patmakesapps/flora-cad/Blender/blender renders/pic_01.png

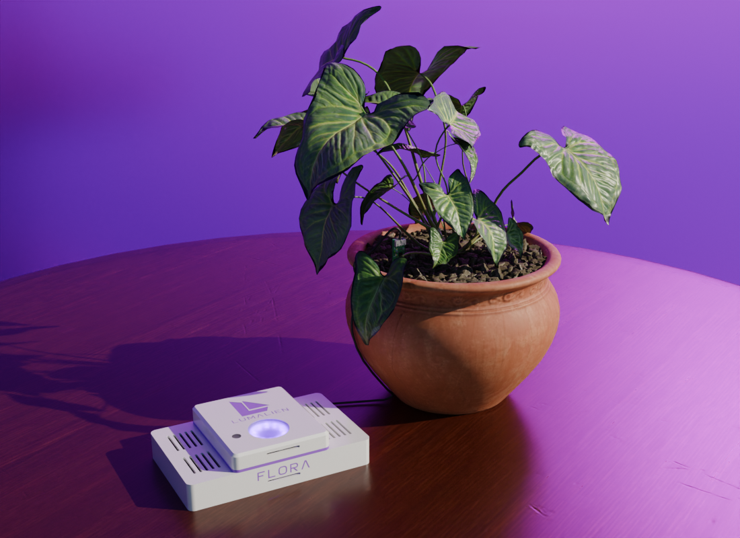
Blender/blender renders/pic_01.png
