patmakesapps/flora-cad/Blender/blender renders/pic_02.png

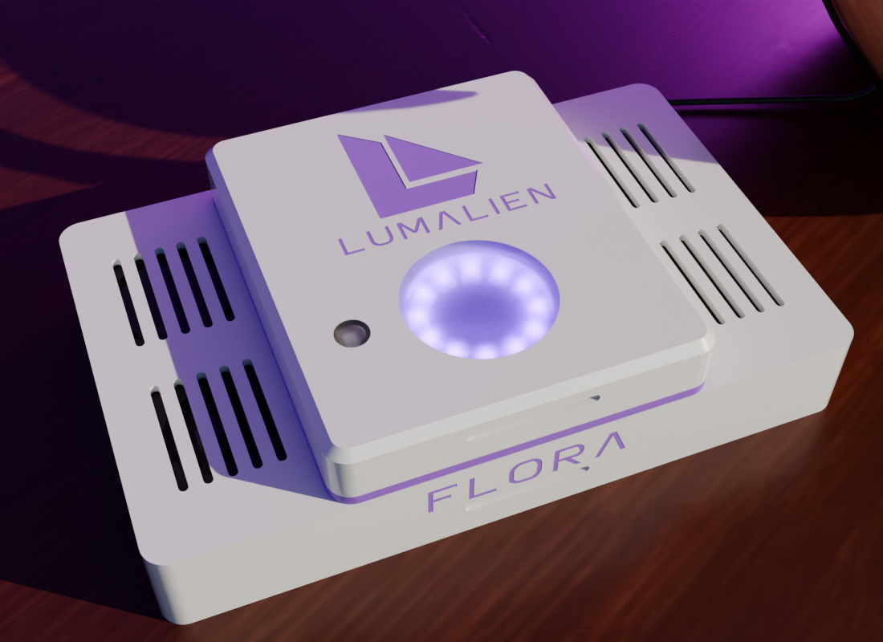
Blender/blender renders/pic_02.png
