patmakesapps/flora-cad/Blender/blender renders/pic_03.png

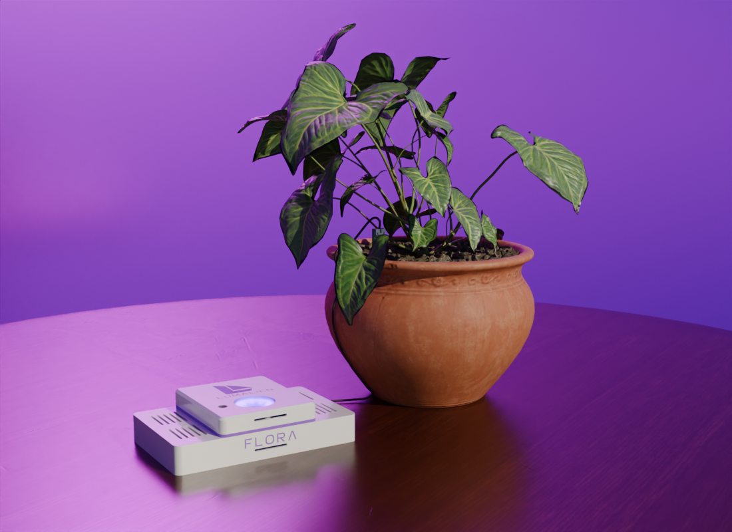
Blender/blender renders/pic_03.png
