patmakesapps/flora-cad/Blender/blender renders/pic_04.png

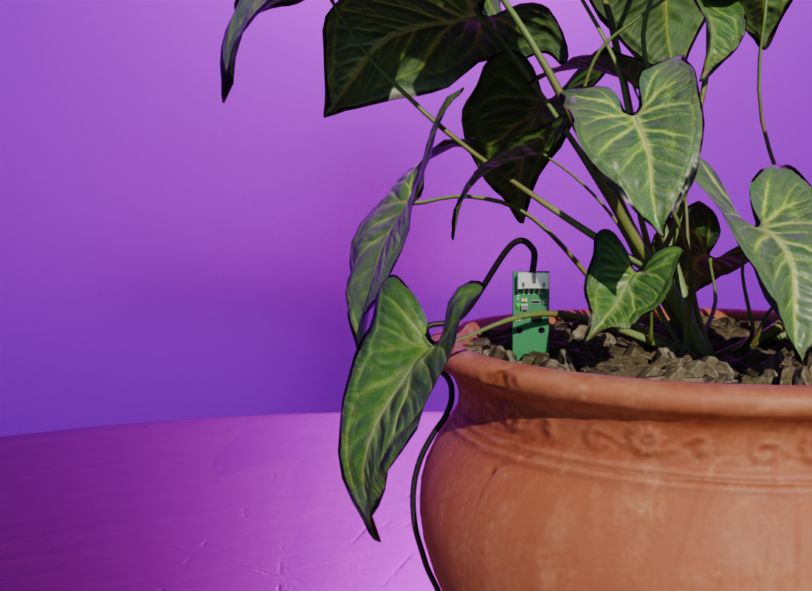
Blender/blender renders/pic_04.png
