patmakesapps/flora-cad/Blender/blender renders/pic_05.png

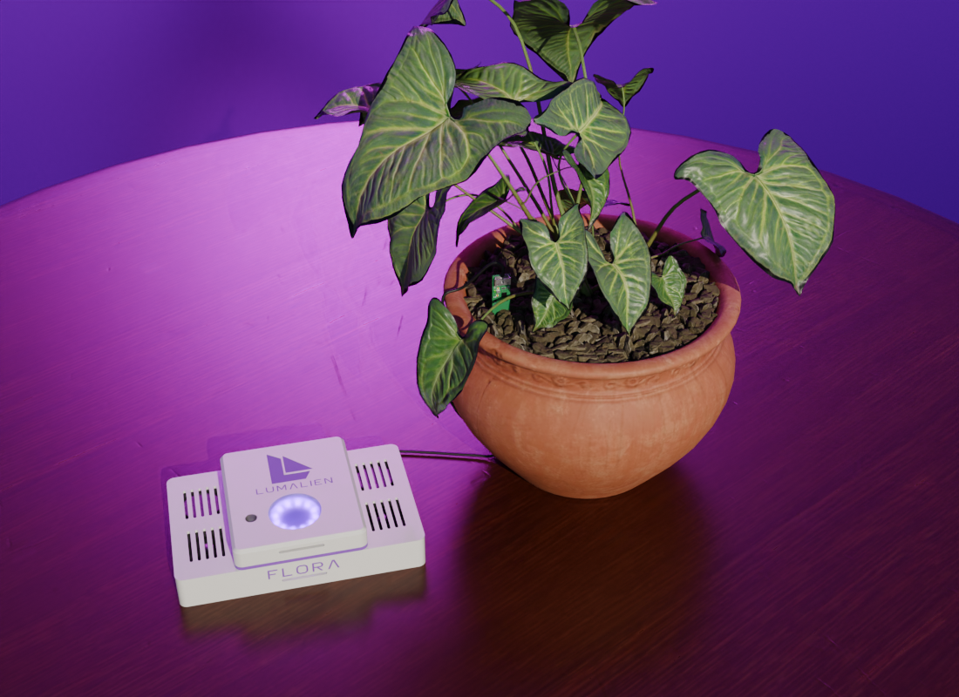
Blender/blender renders/pic_05.png
