patmakesapps/flora-cad/Blender/blender renders/pic_06.png

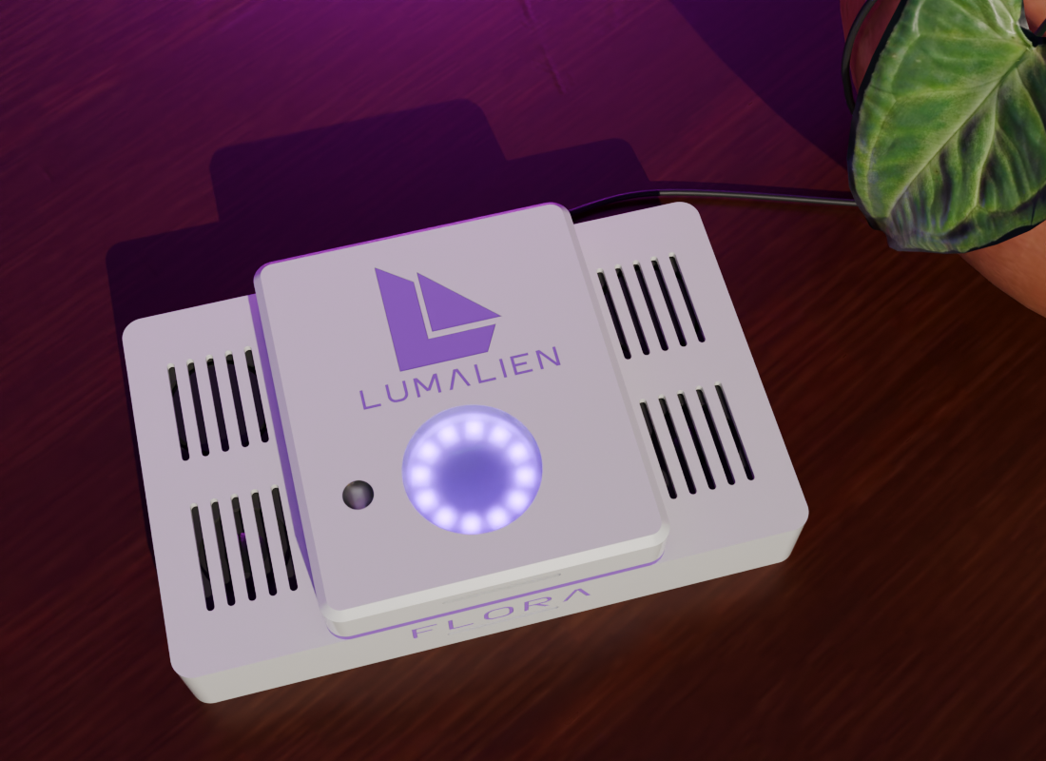
Blender/blender renders/pic_06.png
