patmakesapps/flora-cad/Blender/blender renders/pic_07.png

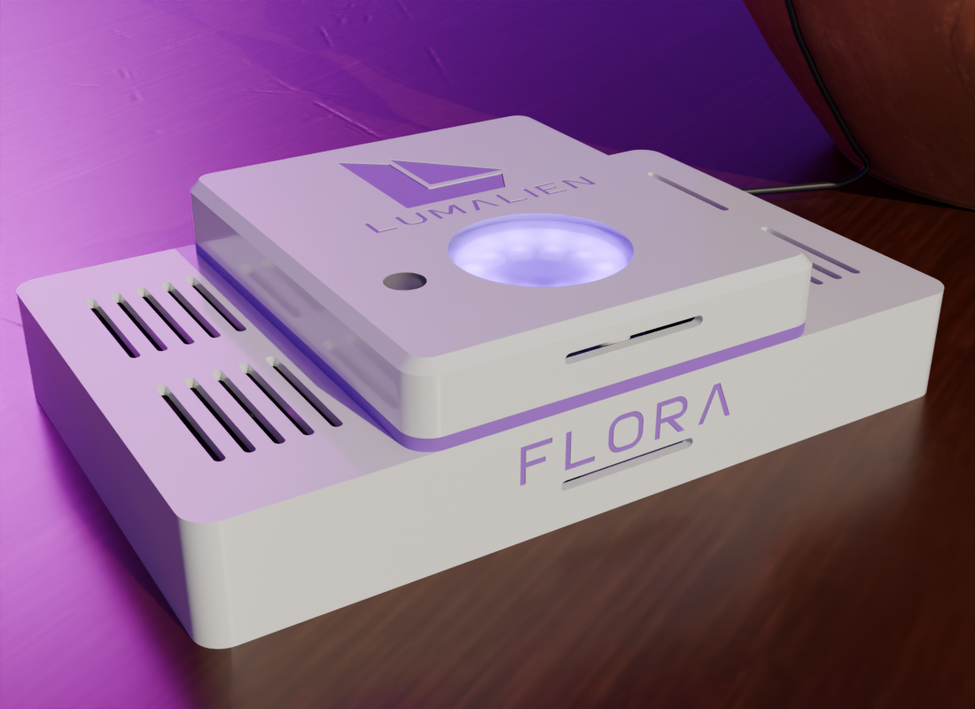
Blender/blender renders/pic_07.png
