patmakesapps/flora-cad/Blender/reference/bench_photos/2026-10-04_bench_01_overview_front_high.jpg

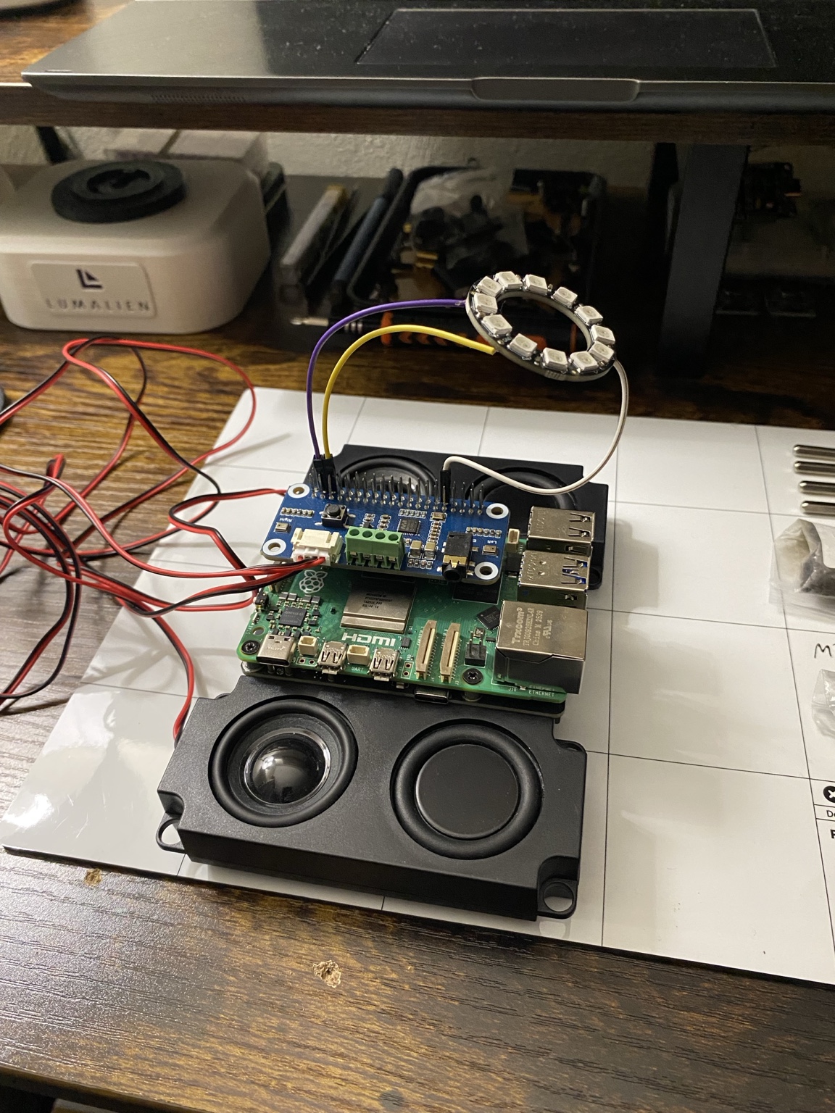
Blender/reference/bench_photos/2026-10-04_bench_01_overview_front_high.jpg
