patmakesapps/flora-cad/Blender/reference/bench_photos/2026-10-04_bench_02_front_usbc_hdmi_edge.jpg

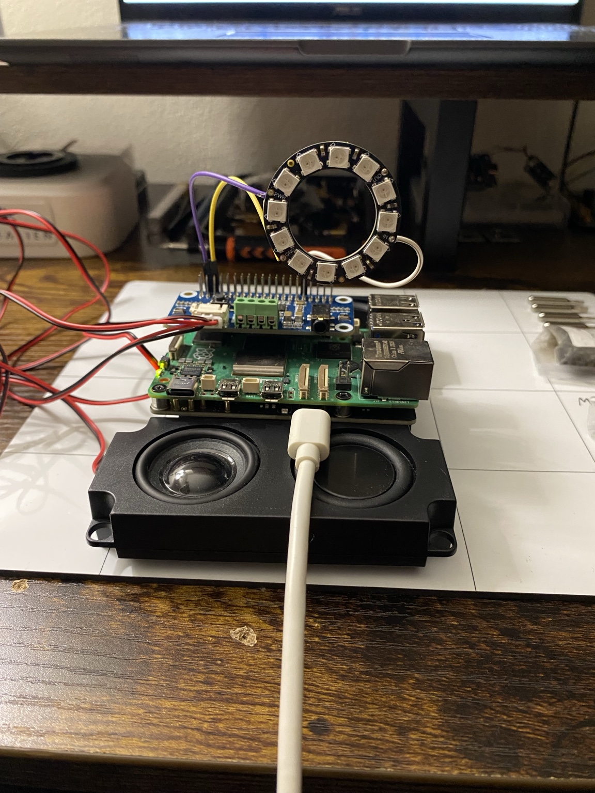
Blender/reference/bench_photos/2026-10-04_bench_02_front_usbc_hdmi_edge.jpg
