patmakesapps/flora-cad/Blender/reference/bench_photos/2026-10-04_bench_03_top_down.jpg

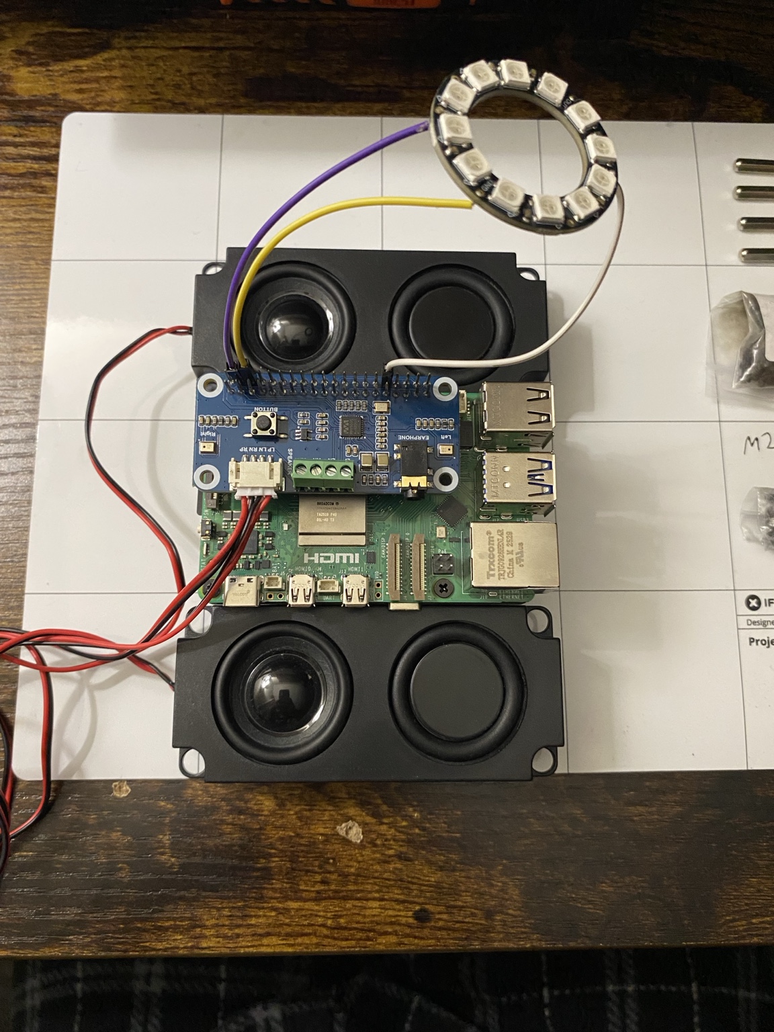
Blender/reference/bench_photos/2026-10-04_bench_03_top_down.jpg
