patmakesapps/flora-cad/Blender/reference/bench_photos/2026-10-04_bench_04_usb_ethernet_end_low.jpg

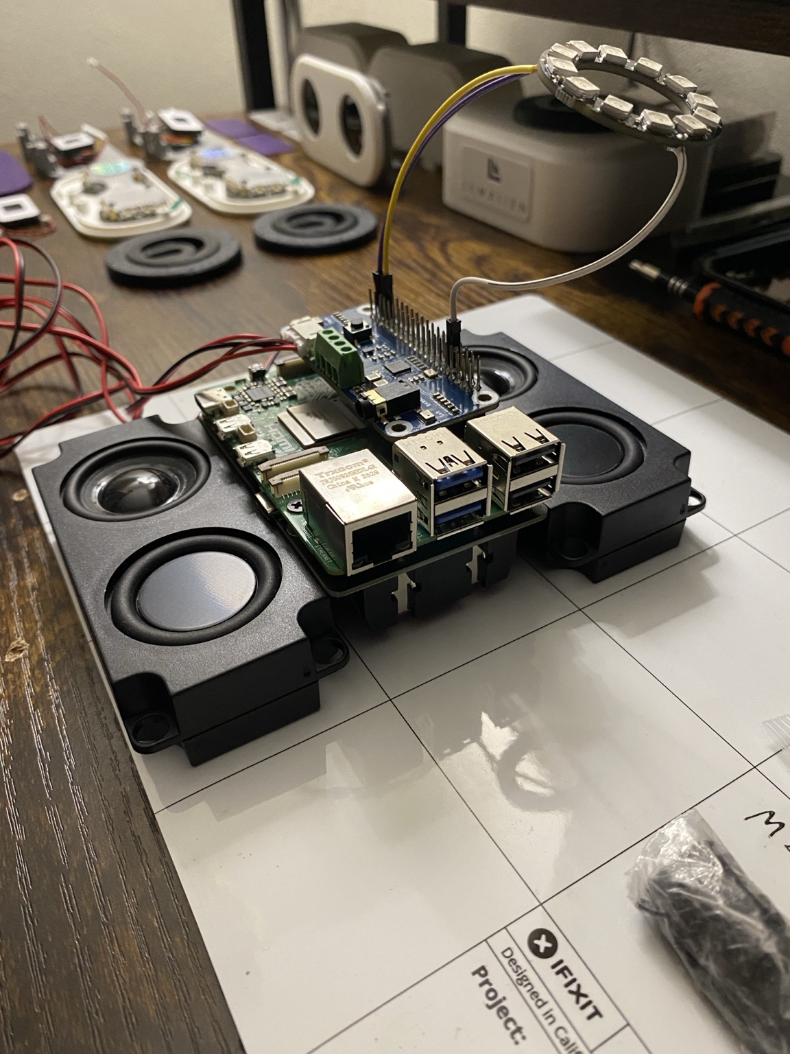
Blender/reference/bench_photos/2026-10-04_bench_04_usb_ethernet_end_low.jpg
