patmakesapps/flora-cad/Blender/reference/bench_photos/2026-10-04_bench_06_pi_stack_only_no_speakers.jpg

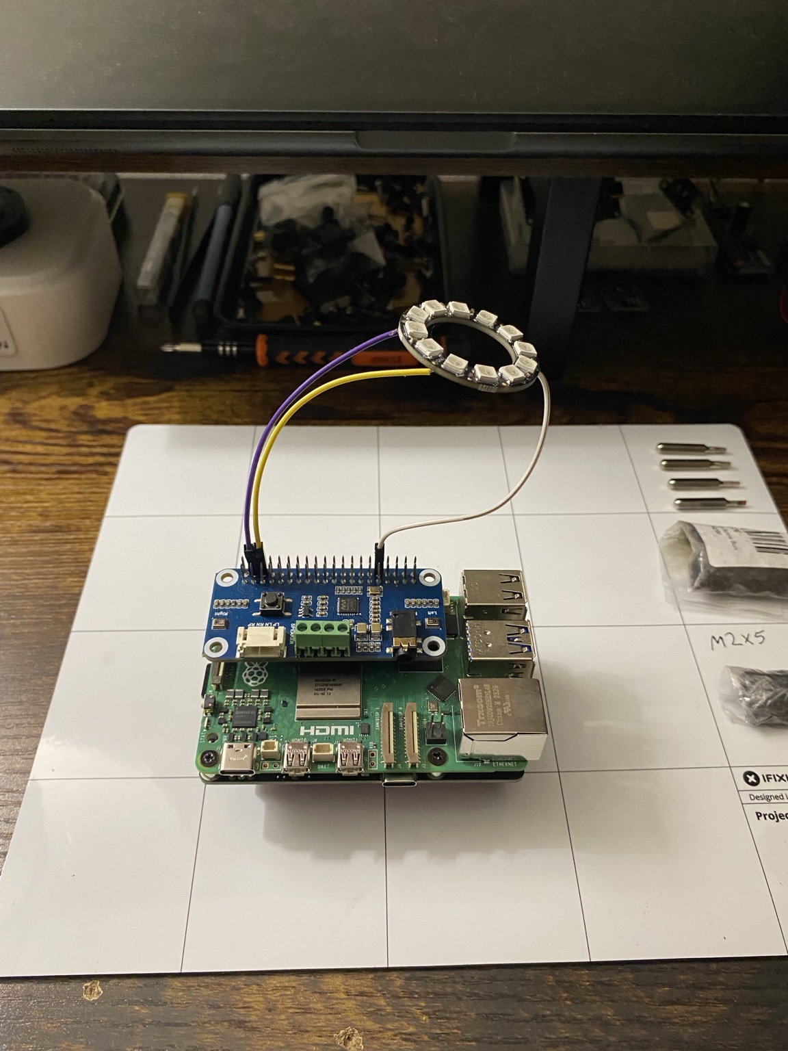
Blender/reference/bench_photos/2026-10-04_bench_06_pi_stack_only_no_speakers.jpg
