patmakesapps/flora-cad/Blender/reference/bench_photos/2026-10-04_bench_07_front_ring_lit_purple.jpg

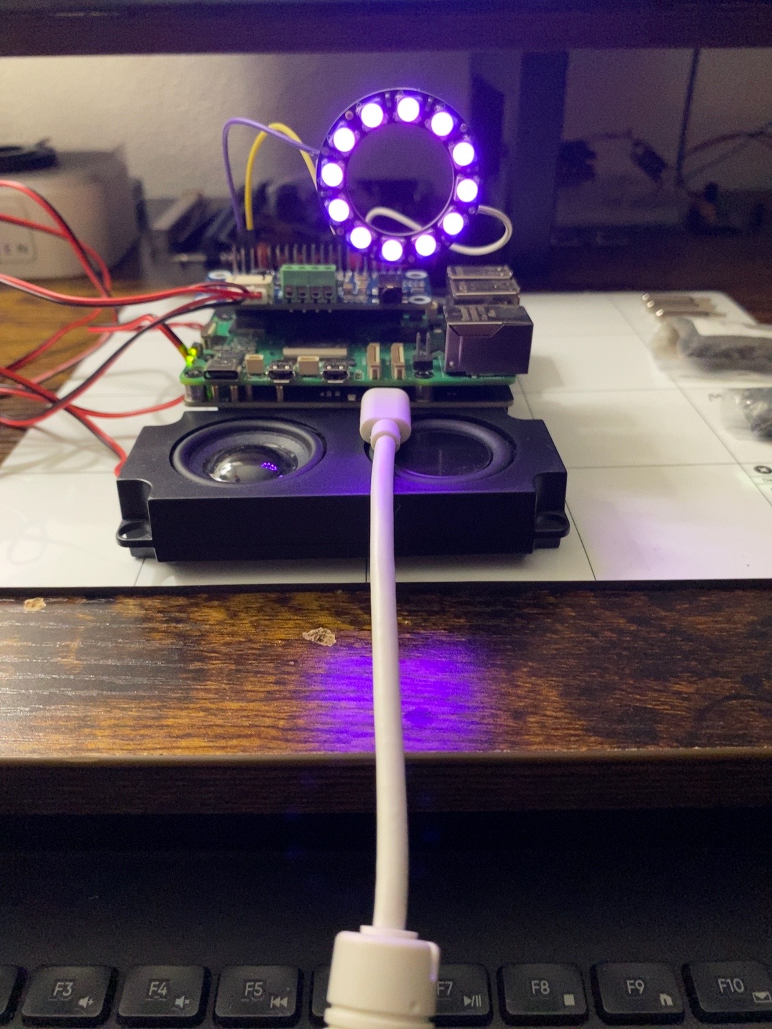
Blender/reference/bench_photos/2026-10-04_bench_07_front_ring_lit_purple.jpg
