patmakesapps/flora-cad/Blender/reference/vendor_cad/adafruit_4026/4026 STEMMA Soil Sensor.step

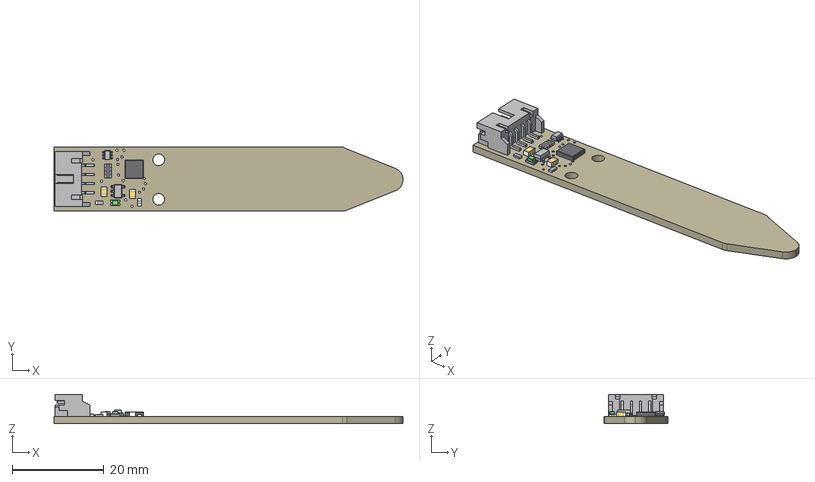
[picture p16: CAD file, 2026-10-05]
Blender/reference/vendor_cad/adafruit_4026/4026 STEMMA Soil Sensor.step
76.2 x 14.0 x 6.37 mm
Board
1K x 2
RED
10uF x 2
MIC5225-3.3
10K
2N7002D
STEMMA_I2C_RASMT
ATSAMD10D14A
