patmakesapps/flora-cad/Blender/reference/vendor_cad/adafruit_4885/4485 SHT40.step

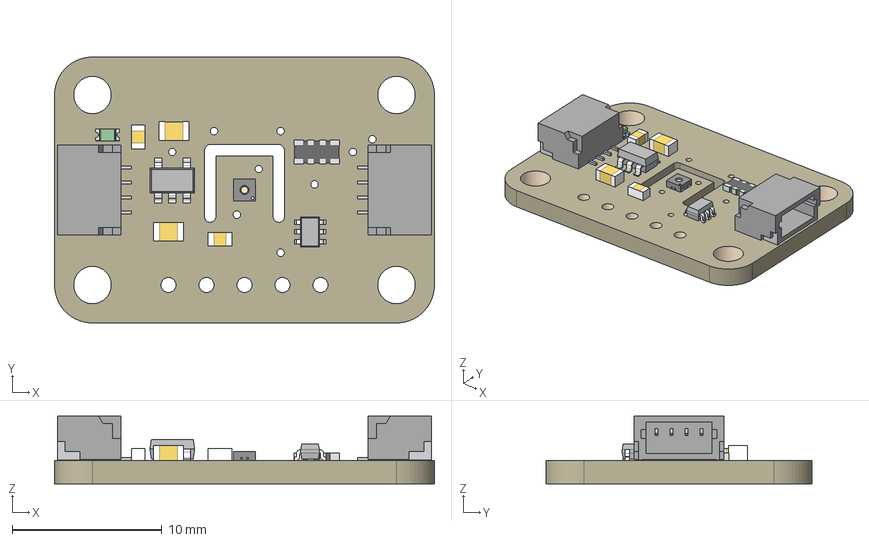
[picture p17: CAD file, 2026-10-05]
Blender/reference/vendor_cad/adafruit_4885/4485 SHT40.step
25.4 x 17.8 x 4.53 mm
Board
10uF x 2
AP2112K-3.3
10K x 2
10K_1
BSS138
STEMMA_I2C_QT x 2
GREEN
SHT4X_
