patmakesapps/flora-cad/Blender/reference/vendor_cad/adafruit_5625/5625 Stemma 5 Port Hub.step

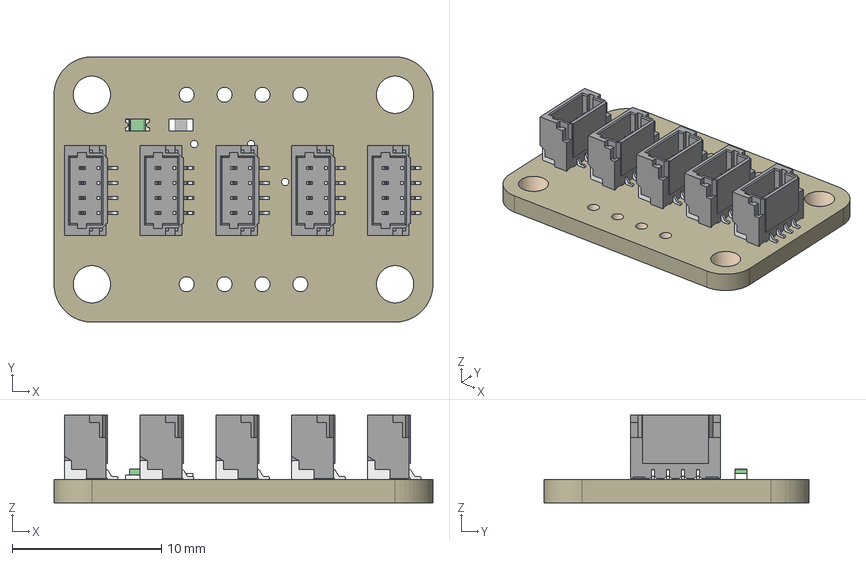
[picture p18: CAD file, 2026-10-05]
Blender/reference/vendor_cad/adafruit_5625/5625 Stemma 5 Port Hub.step
25.4 x 17.8 x 5.87 mm
Board
STEMMA_I2C_QTRA x 5
GREEN
10K
