patmakesapps/flora-cad/STL/FLAT_COLLAR.stl

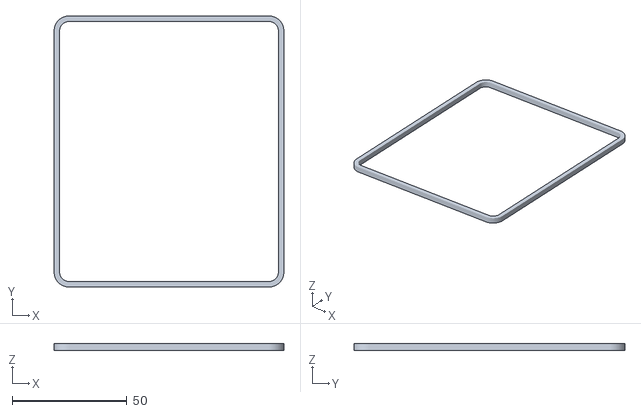
[picture p19: CAD file, 2026-10-05]
STL/FLAT_COLLAR.stl
100.0 x 118.0 x 3.00
