patmakesapps/flora-cad/STL/FLAT_SPINE.stl

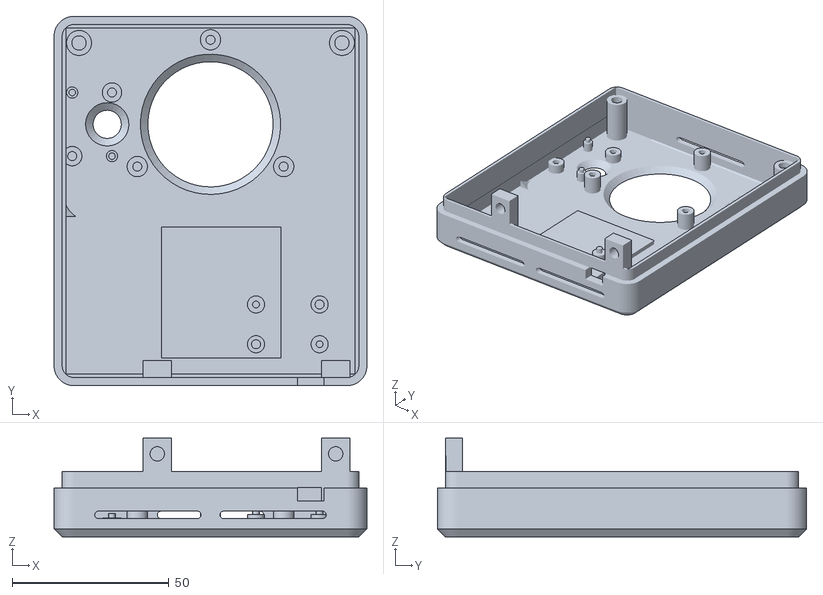
[picture p20: CAD file, 2026-10-05]
STL/FLAT_SPINE.stl
100.0 x 118.0 x 31.5
