patmakesapps/flora-cad/STL/FLAT_BASE.stl

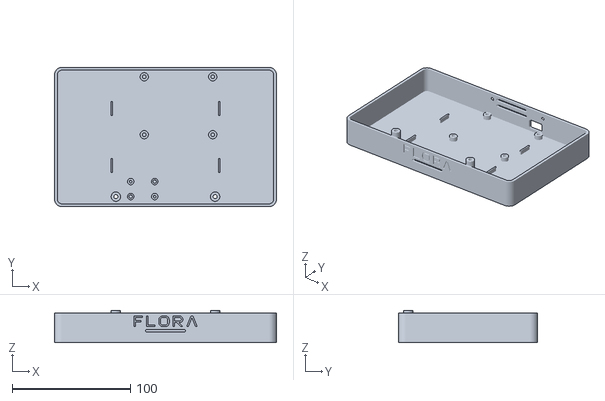
[picture p21: CAD file, 2026-10-05]
STL/FLAT_BASE.stl
188.0 x 118.0 x 27.2
