patmakesapps/flora-cad/STL/FLAT_LUX_WINDOW.stl

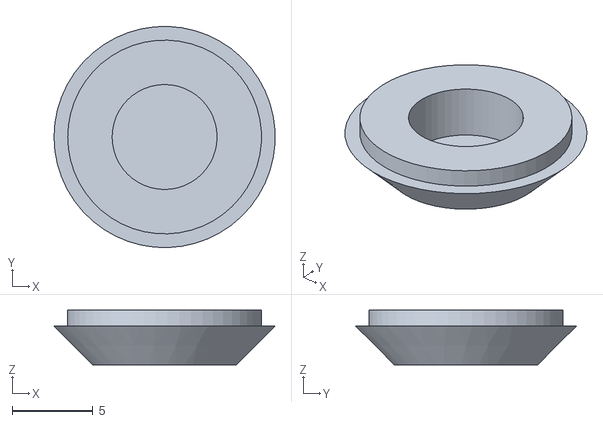
[picture p22: CAD file, 2026-10-05]
STL/FLAT_LUX_WINDOW.stl
13.7 x 13.7 x 3.40
