patmakesapps/flora-cad/STL/FLAT_LOGO_INLAY.stl

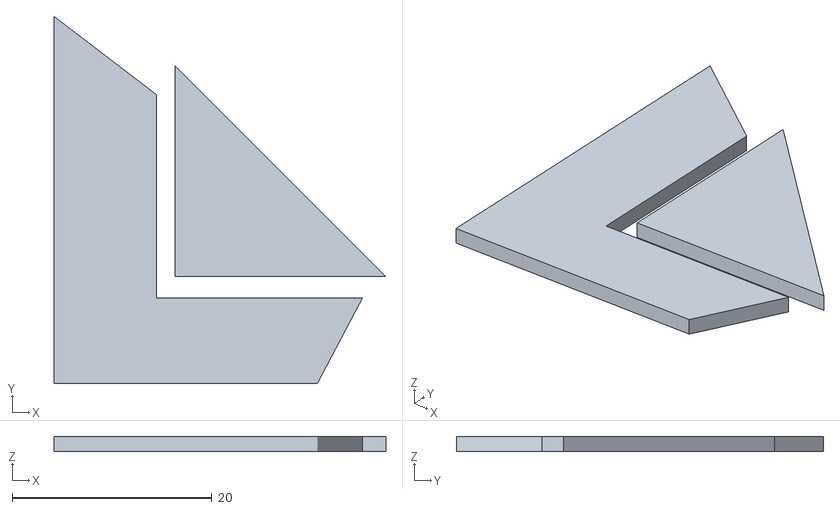
[picture p23: CAD file, 2026-10-05]
STL/FLAT_LOGO_INLAY.stl
33.2 x 36.8 x 1.50
