patmakesapps/flora-cad/STL/FLAT_HALO_RETAINER.stl

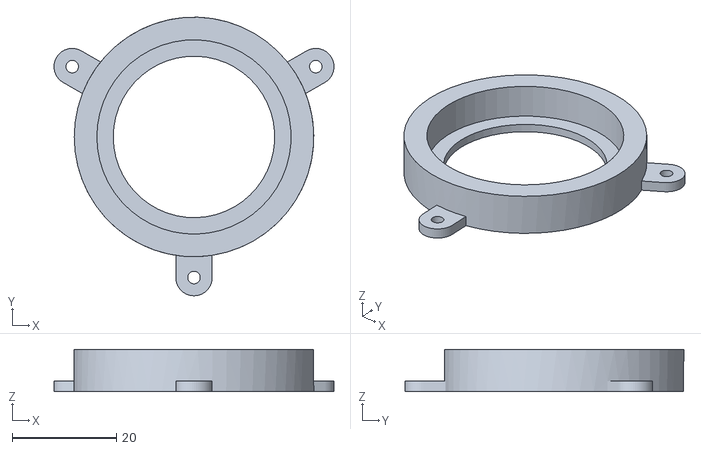
[picture p24: CAD file, 2026-10-05]
STL/FLAT_HALO_RETAINER.stl
53.8 x 53.5 x 8.10
