patmakesapps/flora-cad/STL/FLAT_DECK.stl

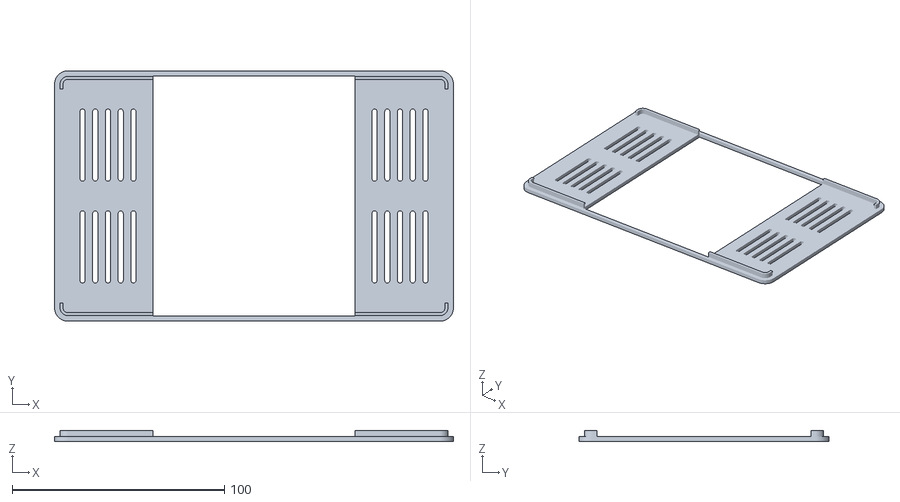
[picture p25: CAD file, 2026-10-05]
STL/FLAT_DECK.stl
188.0 x 118.0 x 5.40
