patmakesapps/flora-cad/STL/FLAT_LUMALIEN_INLAY.stl

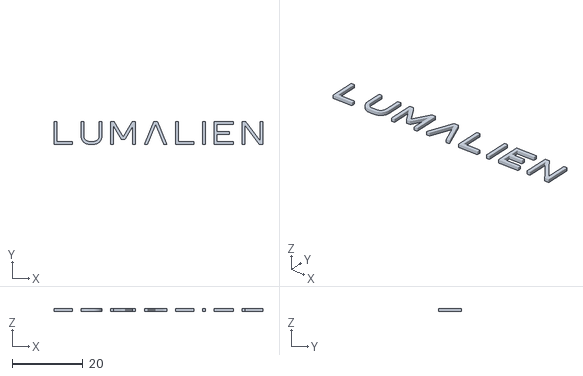
[picture p26: CAD file, 2026-10-05]
STL/FLAT_LUMALIEN_INLAY.stl
59.0 x 6.40 x 0.8
