patmakesapps/flora-cad/STL/FLAT_FLORA_INLAY.stl

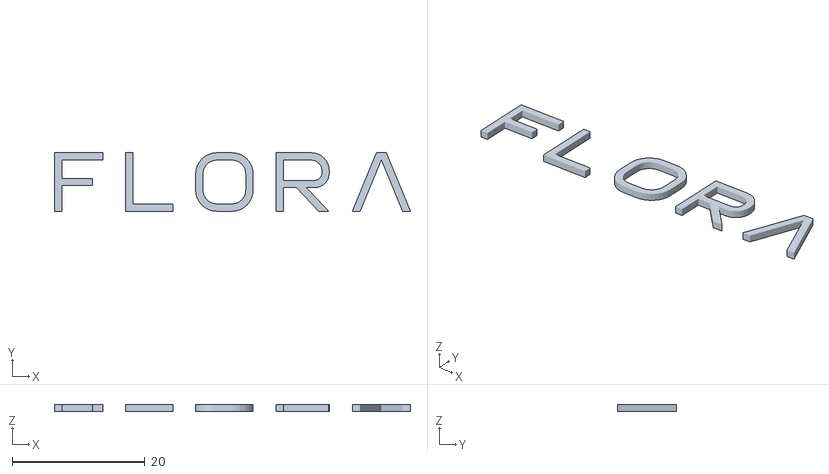
[picture p27: CAD file, 2026-10-05]
STL/FLAT_FLORA_INLAY.stl
53.5 x 8.80 x 1.00
