patmakesapps/flora-cad/STL/FLAT_HALO_LENS.stl

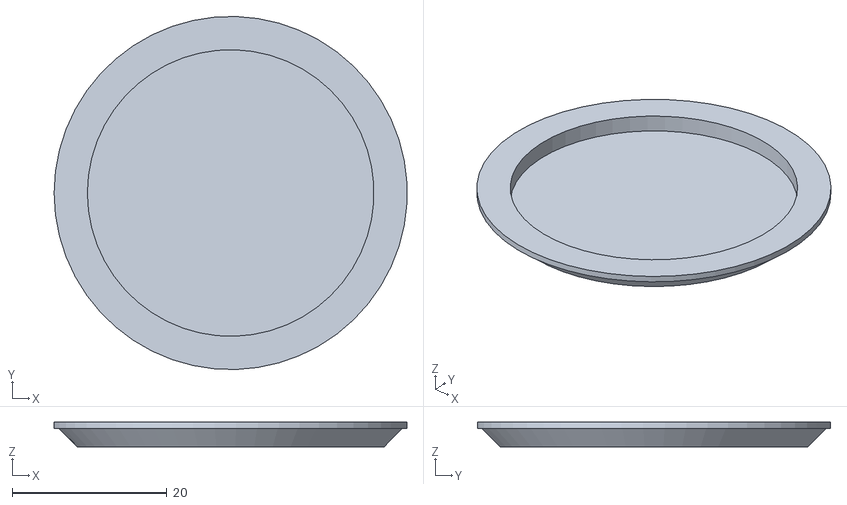
[picture p28: CAD file, 2026-10-05]
STL/FLAT_HALO_LENS.stl
45.6 x 45.6 x 3.20
