patmakesapps/flora-cad/(list of files, cad)

Other CAD files:
Blender/FLORA_v1.blend
Blender/FLORA_v1_renders.blend
