patmakesapps/flora-cad/Blender/reference/bench_photos/2026-10-04_bench_05_sd_card_end_speaker_wiring.jpg

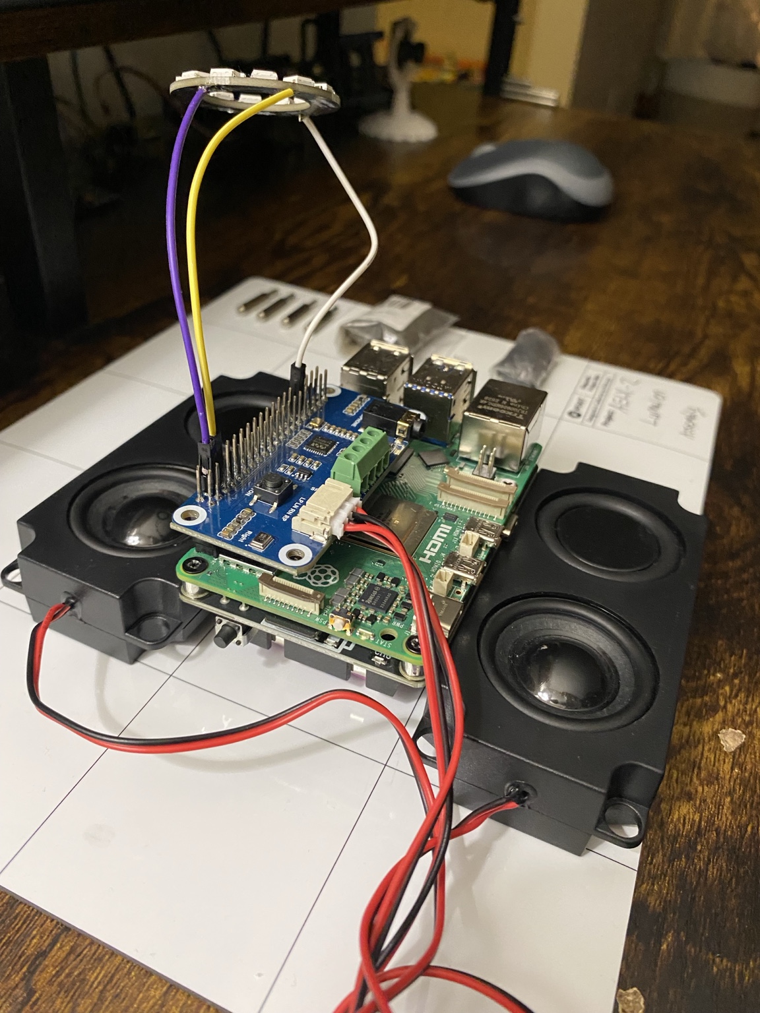
Blender/reference/bench_photos/2026-10-04_bench_05_sd_card_end_speaker_wiring.jpg
