patmakesapps/flora-cad/(commit log)

2026-10-05 Add FLORA parts library base
    Blender file with the bench electronics and the Adafruit sensor order
    modelled at real size (1 unit = 1 mm), parked ready for placement:
    Pi 5, WM8960 audio HAT and speakers, NeoPixel ring, soil sensor,
    VEML7700, 5-port QT hub, SHT41 and the four STEMMA QT cables.
    Reference folder holds the 2026-10-04 bench photos, the vendor CAD the
    sensor models were built from, and notes on what the photos do and do
    not represent.
    [4026 STEMMA Soil Sensor.step, 4485 SHT40.step, 5625 Stemma 5 Port Hub.step, Adafruit VEML7700 STEMMA QT.brd, FLORA_v1.blend]
2026-10-05 Note speaker mounting in the design brief
    Speakers are held with zip ties and/or glue. Also picks up the latest
    save of FLORA_v1.blend.
    [FLORA_v1.blend]
2026-10-05 Add first enclosure concept (FLORA v1) and the L logo
    Upright white pod, 108 x 76 x 128 mm, around the real electronics:
    body, purple collar, cap with an upward-facing NeoPixel halo and lux
    window, a slide-in sled for the Pi, hub and SHT41, and a leaf-shaped
    front grille. Built at the origin in FLORA ASSEMBLY, with linked copies
    of the electronics placed inside. Clash-checked against every placed
    part.
    The Lumalien L mark is imported and parked beside it, unused so far.
    FLORA_SPEC.md records the layout, print parts, hardware, what was
    checked and what is still a guess. No print files exported.
    [FLORA_v1.blend]
2026-10-05 Add flat console concept; rework tall pod vents
    - New flat enclosure (188 x 118 x 46): speakers flat left and right,
    Pi between them, raised centre spine with the halo and lux window.
    - L logo recess in the spine top with a purple glue-in inlay.
    - Tall pod kept as a hidden backup collection; its vents replaced by
    16 uniform slots. Original slit body and a vent-free blank kept too.
    - Spec and README describe both concepts.
    [FLORA_v1.blend]
2026-10-05 Flat console: lettering inlays, hub to rear, soil cable, thin lux window
    - FLORA and LUMALIEN in a custom wide single-weight font, as pockets
    with purple glue-in inlay letters.
    - QT hub moved under the spine top next to the rear notch so the
    200 mm soil cable reaches; soil sensor and its cable modelled.
    - Lux window hollowed to a 0.4 mm face for clear filament.
    - Spec updated to match.
    [FLORA_v1.blend]
2026-10-05 Add STL exports and hardware list; rear spine screws; fit bumper feet
    - STL/: the flat console's ten printed parts, in mm, in print orientation.
    - HARDWARE.md: inserts and screws for each printed part.
    - Spine gains two rear tabs fastened by M3 x 6 screws through the
    tray's back wall; rear intake slots shifted to make room.
    - Foot recesses resized for 12.7 mm bumper feet.
    [FLAT_BASE.stl, FLAT_COLLAR.stl, FLAT_DECK.stl, FLAT_FLORA_INLAY.stl, FLAT_HALO_LENS.stl, FLAT_HALO_RETAINER.stl, FLAT_LOGO_INLAY.stl, FLAT_LUMALIEN_INLAY.stl]
2026-10-05 Round the spine and collar corners to match the tray and deck
    - Spine and collar get the tray's R6.4 plan corners (inside R4, wall
    stays 2.4); the spine's 2.5 mm top chamfer follows the corners.
    - Re-export FLAT_SPINE.stl and FLAT_COLLAR.stl.
    [FLAT_COLLAR.stl, FLAT_SPINE.stl, FLORA_v1.blend]
2026-10-05 Add render scene and first renders
    - Blender/FLORA_v1_renders.blend: the flat console on a table with a
    potted plant, sky HDRI, sunlit wall set, and the 12 NeoPixel lights
    sharing one light datablock.
    - Blender/blender renders/: pic_01 and pic_02.
    [FLORA_v1_renders.blend]
2026-10-05 Render scene: restore the purple backdrop
    [FLORA_v1_renders.blend]
2026-10-13 Add BOM.md and product photos; link the software repo and project page
